joeferner/dc-electronic-load/firmware/README.md

stlink
------

```
st-util -v
./run-gdb.sh
```
