joeferner/dc-electronic-load/docs/competition.md

Re:load Pro
-----------

http://www.arachnidlabs.com/reload-pro/

- 25W continuously
- 6A or 60V
- Works down to 0V
- milliamp precision
- Overcurrent, overvoltage, overtemperature, ESD, and reverse polarity protection.
- USB monitoring

BK Precision 8540
-----------------

http://www.bkprecision.com/products/dc-electronic-loads/8540-150-w-dc-electronic-load.html

Keysight 6060B
--------------

http://www.keysight.com/en/pd-1000001519%3Aepsg%3Apro-pn-6060B/300-watt-dc-electronic-load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
