joeferner/dc-electronic-load/docs/calibration.ods

Sheet: Voltage
ADC | Reading
0 | 0
840 | 5.08
1025 | 6.192
526 | 3.181
331 | 2.004
1291 | 7.79
1715 | 10.35
2481 | 14.97

Sheet: Amps Read
ADC | Reading
0 | 0
2 | 5.17
11 | 15.65
23 | 30.9
35 | 45.8
48 | 62.3
83 | 105.1

Sheet: Amps Set
Set | Reading
0 | 0
0 | 5.16
20 | 25.84
50 | 63.5
80 | 101.3
120 | 151.4
150 | 188.5
