joeferner/dc-electronic-load/hardware/buttons.kicad_pcb

## KiCad design hardware/buttons.kicad_pcb (2014-11-10)

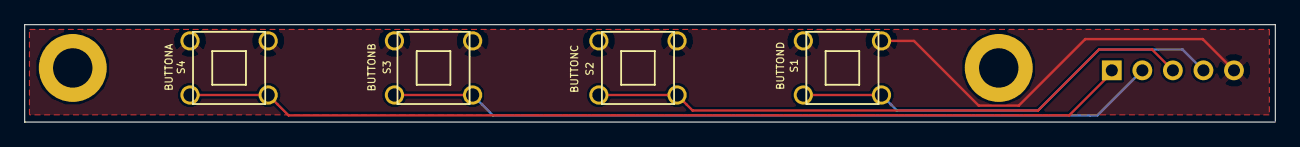
[picture p1: board buttons.kicad_pcb from above]

Board: 2 copper layers, 104.0 x 8.1 mm, 7 parts (1 on the bottom side), 5 nets.

Parts:
M1, M2: Mounting Hole; MTGNP565H328Z565P
P1: P05; JST-B5B-XH-A
S1: BUTTOND; TL1105SP
S2: BUTTONC; TL1105SP
S3: BUTTONB; TL1105SP
S4: BUTTONA; TL1105SP

Connections:
GNDPWR: P1.5, S1.3, S1.4, S2.3, S2.4, S3.3, S3.4, S4.3, S4.4
unnamed: P1.1, S4.1, S4.2
unnamed: P1.2, S3.1, S3.2
unnamed: P1.3, S2.1, S2.2
unnamed: P1.4, S1.1, S1.2
