joeferner/dc-electronic-load/hardware/dc-electronic-load.kicad_pcb

## KiCad design hardware/dc-electronic-load.kicad_pcb (2014-10-13)

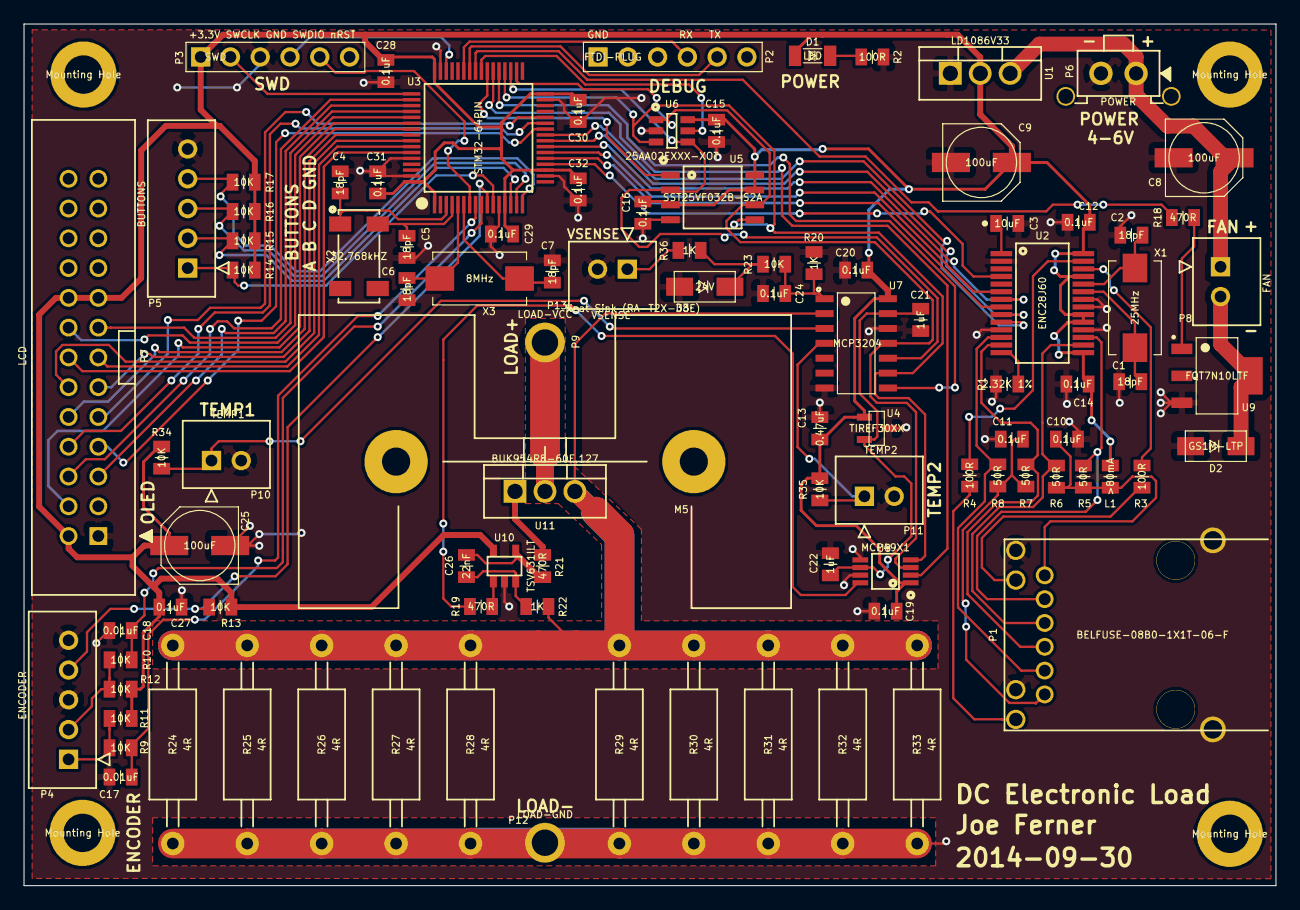
[picture p2: board dc-electronic-load.kicad_pcb from above]

Board: 2 copper layers, 106.8 x 73.5 mm, 107 parts (0 on the bottom side), 78 nets.

Parts:
C1, C2, C4, C5, C6, C7: 18pF; CAPC2012X100N
C3: 10uF; CAPCP2012X100N
C8, C9, C25: 100uF; CAPAE660X790N
C10, C11, C12, C14, C15, C16, C19, C20, C24, C27, C28, C29, C30, C31, C32: 0.1uF; CAPC2012X100N
C13: 0.47uF; CAPC2012X100N
C17, C18: 0.01uF; CAPC2012X100N
C21, C22: 1uF; CAPC2012X100N
C26: 22nF; CAPC2012X100N
D1: LED; LEDC3216X100N
D2: GS1M-LTP; DIOM5226X220N
D3: 24V; DIOM5226X220N
L1: >80mA; RESC2012X100N
M1, M2, M3, M4: Mounting Hole; MTGNP565H328Z565P
M5: Heat Sink (RA-T2X-38E); OHMITE-R-SERIES
M6: Power Entry Connector; EMPTY
M7: Enclosure (8.36x9.11x3.15); EMPTY
M8: Fan (50mm x 10mm); EMPTY
M9: Fan Guard; EMPTY
P1: BELFUSE-08B0-1X1T-06-F; BEL-FUSE-08B0-1X1T-06-F
P2: FTDI-PLUG; HDRV6W66P254_1X6_1524X249X838P
P3: SWD; HDRV6W66P254_1X6_1524X249X838P
P4: ENCODER; JST-B5B-XH-A
P5: BUTTONS; JST-B5B-XH-A
P6: POWER; TECONN-2-1445050-2
P7: LCD; SHDRV26W100P254_2X13_4052X880X910P
P8: FAN; JST-B2B-XH-A
P9: LOAD-VCC; PAD205P
P10: TEMP1; JST-B2B-XH-A
P11: TEMP2; JST-B2B-XH-A
P12: LOAD-GND; PAD205P
P13: VSENSE; JST-B2B-XH-A
R1: 2.32K 1%; RESC2012X100N
R2, R3, R4: 100R; RESC2012X100N
R5, R6, R7, R8: 50R; RESC2012X100N
R9, R10, R11, R12, R13, R14, R15, R16, R17, R23, R34, R35: 10K; RESC2012X100N
R18, R19, R21: 470R; RESC2012X100N
R20, R22, R36: 1K; RESC2012X100N
R24, R25, R26, R27, R28, R29, R30, R31, R32, R33: 4R; RESAD1690W80L890D400P
U1: LD1086V33; TO255P460X1020X1925-3P
U2: ENC28J60; SOP65P780X200-28N
U3: STM32-64PIN; QFP50P1200X1200X160-64N
U4: TIREF30XX; SOT95P237X112_123-3N
U5: SST25VF032B-S2A; SOIC127P790X216-8N
U6: 25AA02EXXX-XOT; SOT95P270X145-6N
U7: MCP3204; SOIC127P600X175-14N
U8: MCP49X1; SOP65P490X110-8N
U9: FQT7N10LTF; SOT230P700X180-4N
U10: TSV631ILT; SOT95P280X100-5N
U11: BUK954R8-60E,127; TO255P460X1020X1925-3P
X1: 25MHz; XTAL8045X200N
X2: 32.768kHZ; SOJ550P370X240-4N
X3: 8MHz; XTAL8045X200N

Connections:
+3.3V: C9.1, C12.1, C13.1, C14.1, C15.1, C16.1, C19.1, C20.1, C25.1, C27.1, C28.1, C29.1, C30.1, C31.1, C32.1, D1.1, L1.1, P3.1, P7.2, P7.17, P7.18, R11.1, R12.1, R13.1, R14.1, R15.1, R16.1, R17.1, R34.2, R35.2, U1.2, U2.15, U2.19, U2.20, U2.25, U2.28, U3.1, U3.13, U3.19, U3.32, U3.48, U3.64, U4.1, U5.3, U5.7, U5.8, U6.6, U7.14, U8.1, U10.5
+5V: C8.1, P6.1, P8.1, U1.3
/ADCCS: U3.37, U7.8
/BUTTONA: P5.1, R14.2, U3.11
/BUTTONB: P5.2, R15.2, U3.14
/BUTTONC: P5.3, R16.2, U3.15
/BUTTOND: P5.4, R17.2, U3.16
/DACCS: U3.38, U8.2
/DEBUGRX: P2.4, U3.43
/DEBUGTX: P2.5, U3.42
/ENC28J60CS: U2.9, U3.24
/ENC28J60INT: U2.4, U3.20
/ENC28J60RESET: U2.10, U3.25
/ENCODERA: C17.1, R9.2, U3.8
/ENCODERB: C18.1, R10.2, U3.9
/ENCODERBUTTON: P4.4, R13.2, U3.10
/FAN: R18.2, U3.41
/FLASHCS: U3.39, U5.1
/ISENSE: R22.1, R24.1, R25.1, R26.1, R27.1, R28.1, R29.1, R30.1, R31.1, R32.1, R33.1, U7.2, U11.3
/LCDCS: P7.16, U3.53
/LCDDATA0: P7.7, U3.26
/LCDDATA1: P7.8, U3.27
/LCDDATA2: P7.9, U3.28
/LCDDATA3: P7.10, U3.55
/LCDDATA4: P7.11, U3.56
/LCDDATA5: P7.12, U3.57
/LCDDATA6: P7.13, U3.58
/LCDDATA7: P7.14, U3.59
/LCDDC: P7.4, U3.54
/LCDEN: P7.6, U3.50
/LCDRESET: P7.15, U3.52
/LCDRW: P7.5, U3.51
/MACCS: U3.40, U6.5
/SPI1MISO: U2.6, U3.22
/SPI1MOSI: U2.7, U3.23
/SPI1SCK: U2.8, U3.21
/SPI2MISO: U3.35, U5.2, U6.4, U7.10
/SPI2MOSI: U3.36, U5.5, U6.3, U7.9, U8.4
/SPI2SCK: U3.34, U5.6, U6.1, U7.11, U8.3
/SWCLK: P3.2, U3.49
/SWDIO: P3.4, U3.46
/TEMP1: P10.1, R34.1, U7.3
/TEMP2: P11.1, R35.1, U7.4
/VREF: C21.1, C22.1, U4.2, U7.13, U8.6
/VSENSE: C24.1, R20.2, R23.2, U7.1
/nRST: P3.5, U3.7
GNDPWR: C1.2, C2.2, C3.2, C4.2, C5.2, C6.2, C7.2, C8.2, C9.2, C10.2, C11.2, C12.2, C13.2, C14.2, C15.2, C16.2, C17.2, C18.2, C19.2, C20.2, C21.2, C22.2, C24.2, C25.2, C27.2, C28.2, C29.2, C30.2, C31.2, C32.2, D2.1, D3.1, P1.7, P1.9, P2.1, P3.3, P4.3, P4.5, P5.5, P6.2, P7.1, P10.2, P11.2, P12.1, P13.2, R1.2, R2.2, R20.1, R24.2, R25.2, R26.2, R27.2, R28.2, R29.2, R30.2, R31.2, R32.2, R33.2, U1.1, U2.2, U2.11, U2.18, U2.21, U2.22, U3.12, U3.18, U3.31, U3.47, U3.60, U3.63, U4.3, U5.4, U6.2, U7.7, U7.12, U8.5, U8.7, U9.3, U10.2
unnamed: C1.1, U2.23, X1.1
unnamed: C2.1, U2.24, X1.2
unnamed: C3.1, U2.1
unnamed: C4.1, U3.3, X2.1
unnamed: C5.1, U3.4, X2.4
unnamed: C6.1, U3.5, X3.1
unnamed: C7.1, U3.6, X3.2
unnamed: C10.1, L1.2, P1.1, R5.2, R6.1
unnamed: C11.1, P1.6, R7.2, R8.1
unnamed: C26.1, R21.2, U10.4
unnamed: C26.2, R22.2, U10.3
unnamed: D1.2, R2.1
unnamed: D2.2, P8.2, U9.4
unnamed: D3.2, R23.1, R36.2
unnamed: P1.2, R5.1, U2.17
unnamed: P1.3, R6.2, U2.16
unnamed: P1.4, R7.1, U2.13
unnamed: P1.5, R8.2, U2.12
unnamed: P1.8, R3.1
unnamed: P1.10, R4.1
unnamed: P4.1, R9.1, R11.2
unnamed: P4.2, R10.1, R12.2
unnamed: P9.1, U11.2
unnamed: P13.1, R36.1
unnamed: R1.1, U2.14
unnamed: R3.2, U2.26
unnamed: R4.2, U2.27
unnamed: R18.1, U9.1
unnamed: R19.1, U10.1
unnamed: R19.2, U8.8
unnamed: R21.1, U11.1
