joeferner/dc-electronic-load/firmware/debug.c

#include "platform_config.h"
#include "debug.h"
#include <stm32f10x_usart.h>
#include <stm32f10x_gpio.h>
#include <stm32f10x_rcc.h>
#include <misc.h>

uint8_t g_debugUsartRxBuffer[DEBUG_USART_RX_BUFFER_SIZE];

char* itoa(int32_t value, char* result, int base);
char* uitoa(uint32_t value, char* result, int base);

void debug_setup() {
  USART_InitTypeDef usartInitStructure;
  GPIO_InitTypeDef gpioInitStructure;
  DMA_InitTypeDef dmaInitStructure;

  GPIO_StructInit(&gpioInitStructure);

  RCC_AHBPeriphClockCmd(RCC_AHBPeriph_DMA1, ENABLE);

#ifdef DEBUG_LED_ENABLE
  RCC_APB2PeriphClockCmd(DEBUG_LED_RCC, ENABLE);
  gpioInitStructure.GPIO_Pin = DEBUG_LED_PIN;
  gpioInitStructure.GPIO_Mode = GPIO_Mode_Out_PP;
  gpioInitStructure.GPIO_Speed = GPIO_Speed_50MHz;
  GPIO_Init(DEBUG_LED_PORT, &gpioInitStructure);
#endif

  RCC_APB2PeriphClockCmd(DEBUG_USART_RCC, ENABLE);

  // Configure USART Tx as alternate function push-pull
  gpioInitStructure.GPIO_Mode = GPIO_Mode_AF_PP;
  gpioInitStructure.GPIO_Pin = DEBUG_USART_TX_PIN;
  gpioInitStructure.GPIO_Speed = GPIO_Speed_50MHz;
  GPIO_Init(DEBUG_USART_TX, &gpioInitStructure);

  // Configure USART Rx as input floating
  gpioInitStructure.GPIO_Mode = GPIO_Mode_IN_FLOATING;
  gpioInitStructure.GPIO_Pin = DEBUG_USART_RX_PIN;
  GPIO_Init(DEBUG_USART_RX, &gpioInitStructure);

  // Configure DMA - RX
  DMA_DeInit(DEBUG_USART_RX_DMA_CH);
  DMA_StructInit(&dmaInitStructure);
  dmaInitStructure.DMA_PeripheralBaseAddr = DEBUG_USART_DR_BASE;
  dmaInitStructure.DMA_MemoryBaseAddr = (uint32_t)g_debugUsartRxBuffer;
  dmaInitStructure.DMA_DIR = DMA_DIR_PeripheralSRC;
  dmaInitStructure.DMA_BufferSize = DEBUG_USART_RX_BUFFER_SIZE;
  dmaInitStructure.DMA_PeripheralInc = DMA_PeripheralInc_Disable;
  dmaInitStructure.DMA_MemoryInc = DMA_MemoryInc_Enable;
  dmaInitStructure.DMA_Mode = DMA_Mode_Circular;
  dmaInitStructure.DMA_PeripheralDataSize = DMA_PeripheralDataSize_Byte;
  dmaInitStructure.DMA_MemoryDataSize = DMA_MemoryDataSize_Byte;
  dmaInitStructure.DMA_Priority = DMA_Priority_Medium;
  dmaInitStructure.DMA_M2M = DMA_M2M_Disable;
  DMA_Init(DEBUG_USART_RX_DMA_CH, &dmaInitStructure);

  // USART configuration
  USART_StructInit(&usartInitStructure);
  usartInitStructure.USART_BaudRate = DEBUG_USART_BAUD;
  usartInitStructure.USART_WordLength = USART_WordLength_8b;
  usartInitStructure.USART_Parity = USART_Parity_No;
  usartInitStructure.USART_StopBits = USART_StopBits_1;
  usartInitStructure.USART_HardwareFlowControl = USART_HardwareFlowControl_None;
  usartInitStructure.USART_Mode = USART_Mode_Rx | USART_Mode_Tx;
  USART_Init(DEBUG_USART, &usartInitStructure);

  // Enable DMA
  USART_DMACmd(DEBUG_USART, USART_DMAReq_Rx, ENABLE);
  DMA_Cmd(DEBUG_USART_RX_DMA_CH, ENABLE);

  // Enable USART
  USART_Cmd(DEBUG_USART, ENABLE);
}

#ifdef DEBUG_LED_ENABLE
void debug_led_set(int v) {
  if (v) {
    GPIO_SetBits(DEBUG_LED_PORT, DEBUG_LED_PIN);
  } else {
    GPIO_ResetBits(DEBUG_LED_PORT, DEBUG_LED_PIN);
  }
}
#endif

void debug_write_uip_eth_addr(const struct uip_eth_addr* addr) {
  int i;
  for (i = 0; i < 6; i++) {
    if (i > 0) {
      debug_write(":");
    }
    debug_write_u8(addr->addr[i], 16);
  }
}

void debug_write_uip_ip_addr(const uip_ipaddr_t* addr) {
  debug_write_u8(addr->u8[0], 10);
  debug_write(".");
  debug_write_u8(addr->u8[1], 10);
  debug_write(".");
  debug_write_u8(addr->u8[2], 10);
  debug_write(".");
  debug_write_u8(addr->u8[3], 10);
}

void debug_write_line(const char* str) {
  debug_write(str);
  debug_write_ch('\n');
}

void debug_write_bytes(const uint8_t* data, uint16_t len) {
  int i;
  for (i = 0; i < len; i++) {
    debug_write_ch((char) data[i]);
  }
}

void debug_write(const char* str) {
  const char* p = str;
  while (*p) {
    debug_write_ch(*p);
    p++;
  }
}

void debug_write_ch(char ch) {
  USART_SendData(DEBUG_USART, ch);
  while (USART_GetFlagStatus(DEBUG_USART, USART_FLAG_TXE) == RESET);

  // uncomment to get debug output
  //if (g_usb_initialized) {
  //  usb_write((const uint8_t *) &ch, 1);
  //}
}

void debug_write_u8(uint8_t val, uint8_t base) {
  if (base == 16) {
    debug_write_ch(TO_HEX(val >> 4));
    debug_write_ch(TO_HEX(val >> 0));
  } else {
    char buffer[20];
    uitoa(val, buffer, base);
    debug_write(buffer);
  }
}

void debug_write_u16(uint16_t val, uint8_t base) {
  if (base == 16) {
    debug_write_ch(TO_HEX(val >> 12));
    debug_write_ch(TO_HEX(val >> 8));
    debug_write_ch(TO_HEX(val >> 4));
    debug_write_ch(TO_HEX(val >> 0));
  } else {
    char buffer[20];
    uitoa(val, buffer, base);
    debug_write(buffer);
  }
}

void debug_write_u32(uint32_t val, uint8_t base) {
  if (base == 16) {
    debug_write_ch(TO_HEX(val >> 28));
    debug_write_ch(TO_HEX(val >> 24));
    debug_write_ch(TO_HEX(val >> 20));
    debug_write_ch(TO_HEX(val >> 16));
    debug_write_ch(TO_HEX(val >> 12));
    debug_write_ch(TO_HEX(val >> 8));
    debug_write_ch(TO_HEX(val >> 4));
    debug_write_ch(TO_HEX(val >> 0));
  } else {
    char buffer[20];
    uitoa(val, buffer, base);
    debug_write(buffer);
  }
}

void debug_write_i32(int32_t val, uint8_t base) {
  char buffer[20];
  itoa(val, buffer, base);
  debug_write(buffer);
}

void debug_write_u8_array(uint8_t* p, int len) {
  int i;
  for (i = 0; i < len; i++) {
    debug_write_u8(p[i], 16);
    debug_write_ch(' ');
  }
}

void uip_log(char* msg) {
  //debug_write_line(msg);
}
