joeferner/dc-electronic-load/firmware/flashFiles.c

#include <stdlib.h>
#include "flashFiles.h"

static const char mimetype_application_javascript[] = "application/javascript";
static const char mimetype_image_png[] = "image/png";
static const char mimetype_text_css[] = "text/css";
static const char mimetype_text_html[] = "text/html";

  
struct flashFile flashFiles[] = {
  { .filename = "/js/jquery-2.1.1.min.js", .content_type = mimetype_application_javascript, .offset = 0, .size = 84245, .script = serve_flash_file },
  { .filename = "/js/bootstrap.min.js", .content_type = mimetype_application_javascript, .offset = 84245, .size = 31819, .script = serve_flash_file },
  { .filename = "/js/jquery.flot.time.min.js", .content_type = mimetype_application_javascript, .offset = 116064, .size = 6891, .script = serve_flash_file },
  { .filename = "/js/jquery.flot.min.js", .content_type = mimetype_application_javascript, .offset = 122955, .size = 52966, .script = serve_flash_file },
  { .filename = "/js/jquery.flot.axislabels.js", .content_type = mimetype_application_javascript, .offset = 175921, .size = 16940, .script = serve_flash_file },
  { .filename = "/js/dc-electronic-load.js", .content_type = mimetype_application_javascript, .offset = 192861, .size = 4879, .script = serve_flash_file },
  { .filename = "/css/dc-electronic-load.css", .content_type = mimetype_text_css, .offset = 197740, .size = 87, .script = serve_flash_file },
  { .filename = "/css/bootstrap.min.css", .content_type = mimetype_text_css, .offset = 197827, .size = 109518, .script = serve_flash_file },
  { .filename = "/img/glyphicons-halflings.png", .content_type = mimetype_image_png, .offset = 307345, .size = 12799, .script = serve_flash_file },
  { .filename = "/img/glyphicons-halflings-white.png", .content_type = mimetype_image_png, .offset = 320144, .size = 8777, .script = serve_flash_file },
  { .filename = "/amps/set", .content_type = mimetype_text_html, .offset = 328921, .size = 0, .script = serve_amps_set },
  { .filename = "/info", .content_type = mimetype_text_html, .offset = 328921, .size = 0, .script = serve_info },
  { .filename = "/recorder/download", .content_type = mimetype_text_html, .offset = 328921, .size = 0, .script = serve_recorder_download },
  { .filename = "/recorder/stop", .content_type = mimetype_text_html, .offset = 328921, .size = 0, .script = serve_recorder_stop },
  { .filename = "/recorder/start", .content_type = mimetype_text_html, .offset = 328921, .size = 0, .script = serve_recorder_start },
  { .filename = "/ws", .content_type = mimetype_text_html, .offset = 328921, .size = 0, .script = serve_web_socket },
  { .filename = "/index.html", .content_type = mimetype_text_html, .offset = 328921, .size = 3375, .script = serve_flash_file },
  { .filename = NULL, .offset = 0, .size = 0 }
};
