joeferner/dc-electronic-load/firmware/gfx.h

#ifndef _GFX_H_
#define _GFX_H_

#include "platform_config.h"

#ifdef DISP6800_ENABLE

#include <stdint.h>
#include "font.h"

#define GFX_ALIGN_LEFT   0x00000000
#define GFX_ALIGN_RIGHT  0x00000001
#define GFX_ALIGN_CENTER 0x00000002

#define GFX_WIDTH  128
#define GFX_HEIGHT 64

#define GFX_COLOR_BLACK 0x0
#define GFX_COLOR_WHITE 0xf

void gfx_setup();
void gfx_clear();
void gfx_set_pixel(uint8_t x, uint8_t y, uint8_t color);
void gfx_redraw();
void gfx_fill_rect(int x, int y, int width, int height, uint8_t color);
int gfx_draw_string(const char* str, const tFont* font, int x, int y, uint32_t opts);
int gfx_draw_char(char ch, const tFont* font, int x, int y);
int gfx_measure_string_width(const char* str, const tFont* font);
const tChar* gfx_get_char(char ch, const tFont* font);

#endif

#endif // _GFX_H_
