joeferner/dc-electronic-load/firmware/httpd.h

#ifndef _HTTPD_H_
#define _HTTPD_H_

#include "net/ip/psock.h"
#include "platform_config.h"

#ifndef HTTPD_CONNS
#  define HTTPD_CONNS UIP_CONNS
#endif

#ifndef WEBSERVER_CONF_CFS_PATHLEN
#  define HTTPD_PATHLEN 80
#else
#  define HTTPD_PATHLEN WEBSERVER_CONF_CFS_PATHLEN
#endif

#ifndef WEBSERVER_CONF_OUTBUF_SIZE
#  define HTTPD_OUTBUF_SIZE (UIP_TCP_MSS + 20)
#else
#  define HTTPD_OUTBUF_SIZE WEBSERVER_CONF_OUTBUF_SIZE
#endif

#define SEND_STRING(s, str, len) PSOCK_SEND((s), (uint8_t *)(str), (len))

#define HTTPD_GET      1
#define HTTPD_POST     2
#define HTTPD_PUT      3
#define HTTPD_RESPONSE 4

#define HTTPD_STATE_UNUSED         0
#define HTTPD_STATE_INPUT          1
#define HTTPD_STATE_OUTPUT         2
#define HTTPD_STATE_REQUEST_OUTPUT 3

struct httpd_state;
struct flashFile;

typedef char(*httpd_script_t)(process_event_t ev, struct httpd_state* s);

extern struct flashFile* httpd_get_file(const char* filename);

struct httpd_state {
  struct timer timer;
  struct psock sock;
  struct pt outputpt;
  struct flashFile* file;
  uint32_t file_pos;
  uint32_t content_len;
  char sec_websocket_accept[35];
  uint8_t buf[HTTPD_OUTBUF_SIZE];
  uint16_t outbuf_pos;
  uint8_t state;
  uint8_t request_type;
  struct etimer ws_etimer;
};

PROCESS_NAME(httpd_process);
PT_THREAD(send_headers(struct httpd_state* s, const char* statushdr));

#endif
