joeferner/dc-electronic-load/firmware/util.h

#ifndef UTIL_H
#define	UTIL_H

#ifdef	__cplusplus
extern "C" {
#endif

#include <stdint.h>
  
#define BOOL  uint8_t
#define FALSE 0
#define TRUE  1
  
#define ABS(a) ( ((a) < 0) ? -(a) : (a) )
#define MIN(a,b) ( ((a) < (b)) ? (a) : (b) )
#define MAX(a,b) ( ((a) > (b)) ? (a) : (b) )
#define CLAMP(v, min, max) ( ((v) < (min)) ? (min) : ( ((v) > (max)) ? (max) : (v) ) )
  
uint32_t swap_endian(uint32_t val);
void trim_right(char* str);
int is_whitespace(char ch);

#ifdef	__cplusplus
}
#endif

#endif	/* UTIL_H */
