joeferner/dc-electronic-load/(commit log)

2014-08-25 encoder test success
2014-08-26 switch polarity on encoder logic
2014-08-26 working encoder
2014-08-26 print size
2014-08-26 print numbers
2014-08-27 working adc but broken gdb
    [adc.c, adc.h, gfx.c, main.c, network.c, platform_config.h]
2014-08-27 change to etimer instead of polling for adC
2014-08-27 switch to kdevelop
2014-08-28 read current
2014-08-29 working dac
    [worksheets.ods]
2014-08-31 refactor calibration to new functions
2014-09-03 working fan control
2014-09-05 initial hardware
    [dc-electronic-load.kicad_pcb, dc-electronic-load.sch]
2014-09-07 more schematic work
    [dc-electronic-load.sch, worksheets.ods]
2014-09-07 more schematic
    [dc-electronic-load.sch]
2014-09-09 initial schematic complete
    [dc-electronic-load.sch, worksheets.ods]
2014-09-09 more module assigning
    [dc-electronic-load.kicad_pcb, dc-electronic-load.sch]
2014-09-10 add mechanical parts
    [dc-electronic-load.sch]
2014-09-12 add voltage reg module and resistor module
    [dc-electronic-load.kicad_pcb, dc-electronic-load.sch]
2014-09-12 more footprints
    [dc-electronic-load.kicad_pcb, dc-electronic-load.sch]
2014-09-12 add diode
    [dc-electronic-load.kicad_pcb]
2014-09-30 pcb 2014-09-30
    [dc-electronic-load.bom.csv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]
2014-10-04 switch to network
2014-10-07 move spi setup
2014-10-11 working mac
    [dc-electronic-load.kicad_pcb]
2014-10-12 working adc and dac
2014-10-13 working network and fan
    [dc-electronic-load.kicad_pcb]
2014-10-14 remove fan pwm
2014-10-19 working assembly
    [calibration.ods]
2014-10-23 fix post request handling
    [flashsst25.c, flashsst25.h, httpd.c, network.c]
2014-10-24 working web sockets
2014-10-25 fix adc polling too often
    [adc.c, httpd.c]
2014-10-26 working web socket disconnect
2014-11-09 initial buttons pcb
    [buttons.kicad_pcb, buttons.sch]
2014-11-10 buttons 2014-11-09
    [buttons.kicad_pcb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]
2014-11-20 fix button assignment
2014-12-13 fix disable JTAG when not using GDB
    [dcElectronicLoad.c, disp6800.c, main.c, platform_config.h]
2014-12-13 update part numbers
    [dc-electronic-load.sch]
